JenertsA/open-closed-loop/(commit log)

2022-01-24 Revert "direction inverted"
    This reverts commit d19dac375709e53dfce17a27a6fd833da1cce3ff.
    [open-closed-loop.ino]
2022-01-26 Device image added.
