JenertsA/open-closed-loop/(notices)

Notices in the files:
readme.md:
License: MIT
